artemchip/WattMeter/README.md

# Умный электросчетчик
Учет расхода энергии в сетях 220В с помощью трансформатора тока.  
Устройство:  
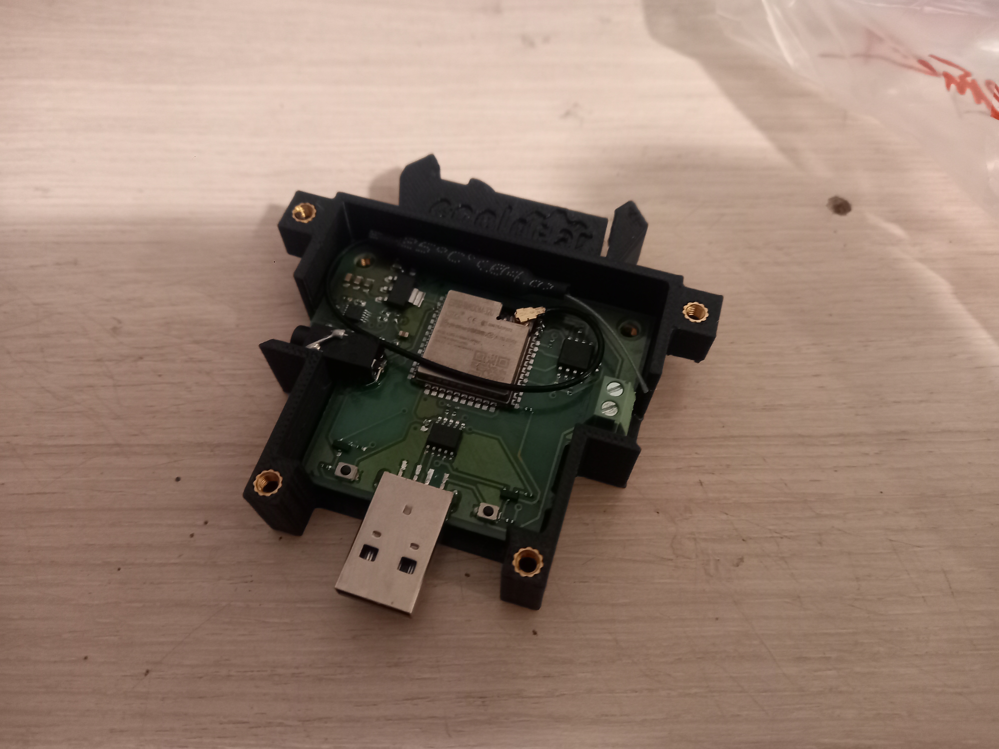
[picture p1: Photos/image1.jpg]

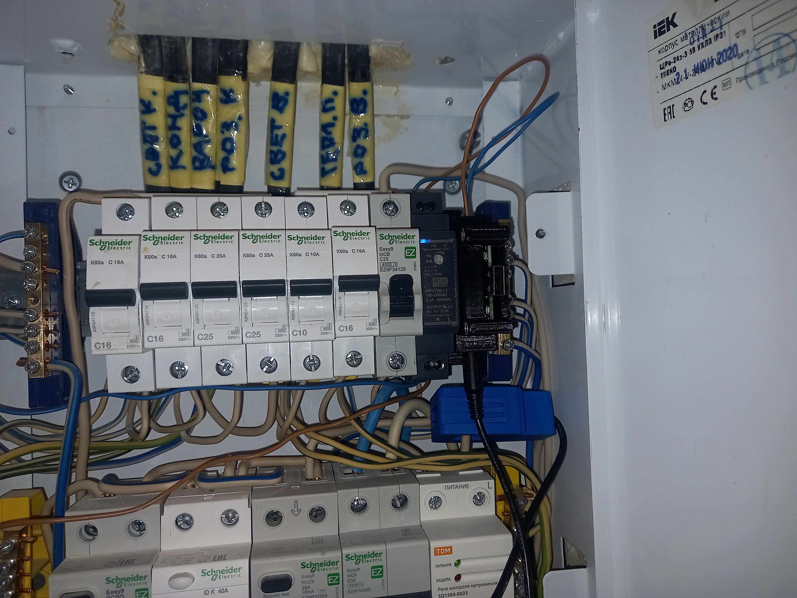
[picture p2: Photos/image2.jpg]

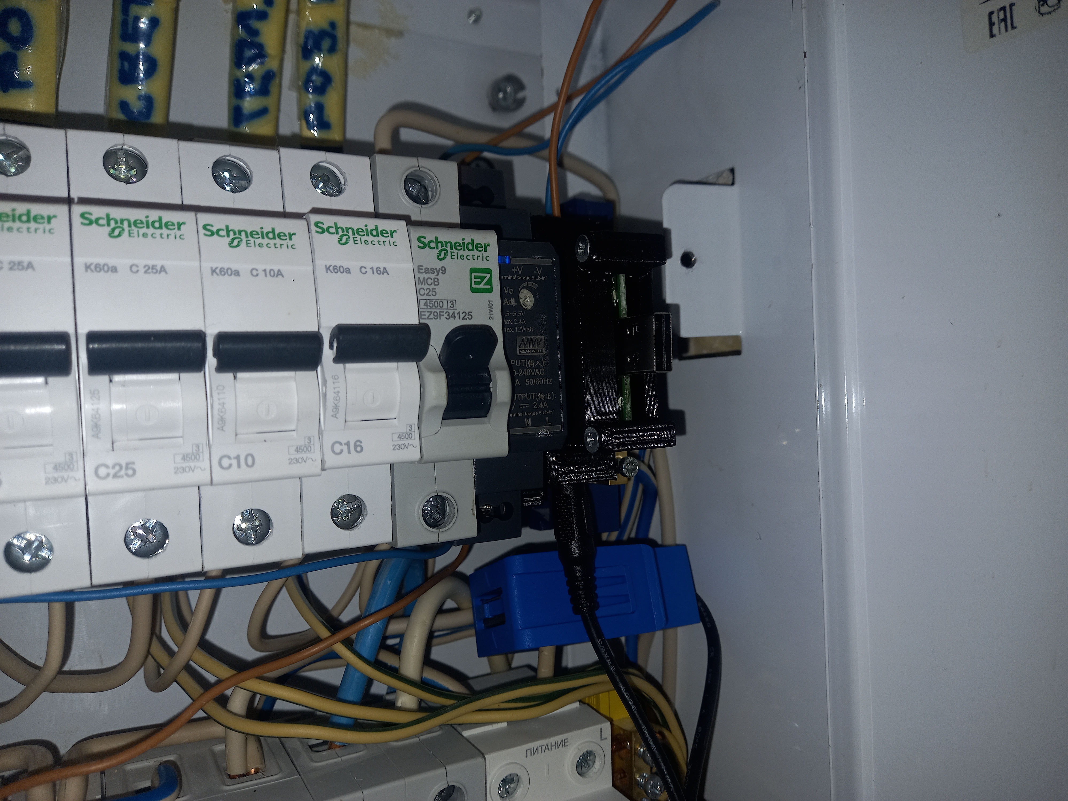
[picture p3: Photos/image3.jpg]

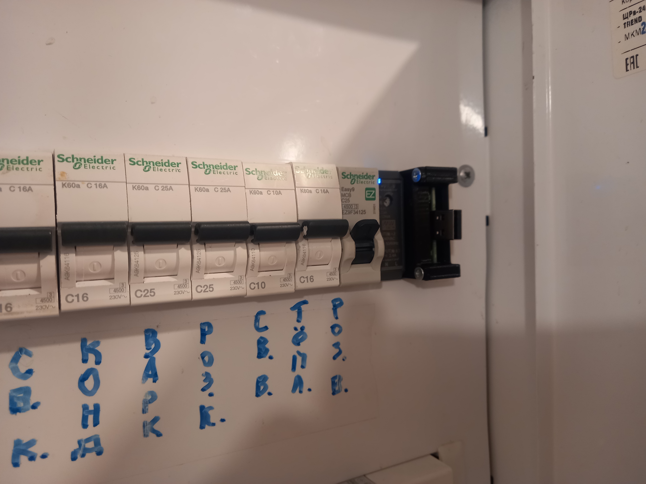
[picture p4: Photos/image4.jpg]


UI:  
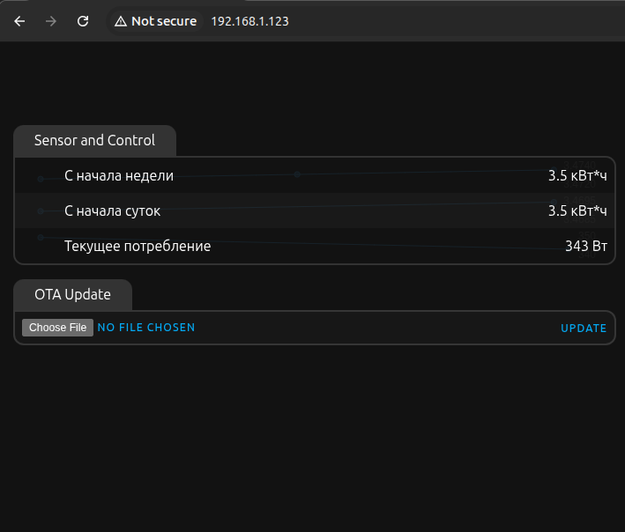
[picture p5: Photos/screenshot.png]


Скоро возможно будет функция постройки графиков.
