artemchip/WattMeter/(list of files, cad)

Other CAD files:
Hardware/wattmeter.blend
