artemchip/WattMeter/Hardware/WattMeter.brd

## EAGLE design Hardware/WattMeter.brd (2026-10-13)

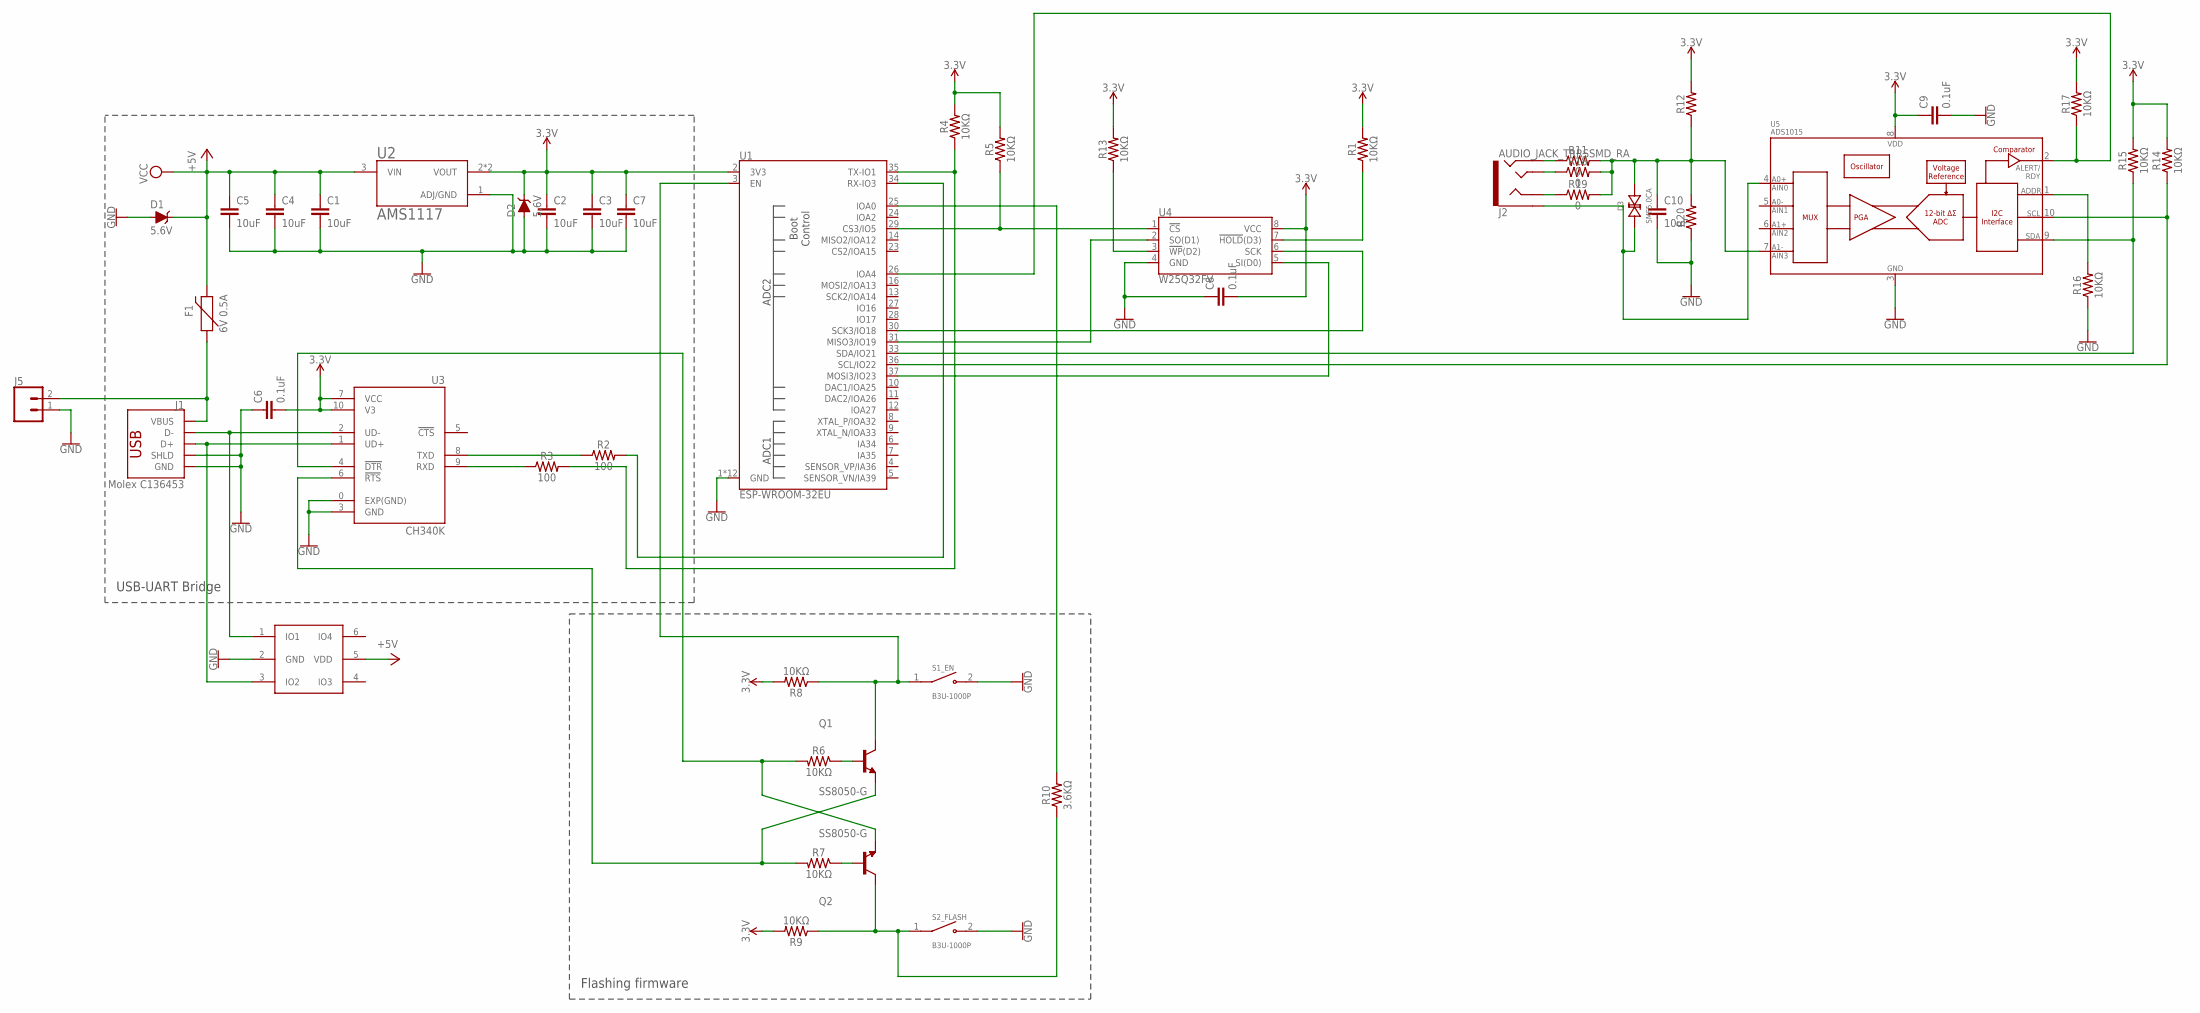
[picture p6: schematic WattMeter.sch]

Parts:
C1, C2, C3, C4, C5, C7, C10: 10uF; 0603
C6, C8, C9: 0.1uF; 0402
D1, D2: 5.6V; SOD-323
D3: SMF5.0CA; SOD-123FL
F1: 6V 0.5A; 0805
J1: Molex C136453; USB-A-SMT-MALE
J2: AUDIO_JACK_TRRSSMD_RA; AUDIO_JACK_3.5MM_TRRS_SMD_RA
J5: CONN_023.5MM; SCREWTERMINAL-3.5MM-2
Q1, Q2: SS8050-G; TRANS_SS8050-G
R1, R4, R5, R6, R7, R8, R9, R13, R14, R15, R16, R17: 10KΩ; 0402-TIGHT
R2, R3: 100; 0402-TIGHT
R10: 3.6KΩ; 0402-TIGHT
R11, R18, R19: 0; 0402
R12, R20: 10KΩ; 0402
S1_EN, S2_FLASH: B3U-1000P; SW_B3U-1000P
U1: ESP-WROOM-32EU
U2: AMS1117; SOT229P700X180-4N
U3: CH340K; SOP100P600X160-11N
U4: W25Q32FV; SOIC-8
U5: ADS1015; MSOP10
U6: AZC099-04S; SOT95P275X110-6N

Connections:
3.3V: C2.1, C3.1, C6.2, C7.1, C8.2, C9.1, D2.C, R1.2, R4.2, R5.2, R8.2, R9.2, R12.2, R13.2, R14.2, R15.2, R17.2, U1.2 (3V3), U2.2 (VOUT), U2.4 (VOUT), U3.7 (VCC), U3.10 (V3), U4.8 (VCC), U5.8 (VDD)
+5V: C1.1, C4.1, C5.1, D1.C, F1.2, U2.3 (VIN), U6.5 (VDD)
GND: C1.2, C2.2, C3.2, C4.2, C5.2, C6.1, C7.2, C8.1, C9.2, C10.2, D1.A, D2.A, J1.GND1 (GND), J1.SHLD1 (SHLD), J1.SHLD2 (SHLD), J5.1, R16.1, R20.1, S1_EN.2, S2_FLASH.2, U1.1 (GND), U1.15 (GND), U1.38 (GND), U1.GND, U1.GNDT1 (GND), U1.GNDT2 (GND), U1.GNDT3 (GND), U1.GNDT4 (GND), U1.GNDT5 (GND), U1.GNDT6 (GND), U1.GNDT7 (GND), U1.GNDT8 (GND), U2.1 (ADJ/GND), U3.0 (EXP(GND)), U3.3 (GND), U4.4 (GND), U5.3 (VSS), U6.2 (GND)
unnamed: J1.D-1 (D-), U3.2 (UD-), U6.1 (IO1)
unnamed: U1.31 (MISO3/IO19), U4.2 (SO(D1))
unnamed: J1.D+1 (D+), U3.1 (UD+), U6.3 (IO2)
unnamed: Q2.1 (B), R7.1
unnamed: R2.1, U3.8 (TXD)
unnamed: Q2.2 (E), R6.2, U3.4 (!DTR)
unnamed: Q1.2 (E), R7.2, U3.6 (!RTS)
unnamed: R3.1, U3.9 (RXD)
unnamed: U1.37 (MOSI3/IO23), U4.5 (SI(D0))
unnamed: U1.30 (SCK3/IO18), U4.6 (SCK)
unnamed: R1.1, U4.7 (!HOLD!(D3))
unnamed: Q2.3 (C), R9.1, R10.1, S2_FLASH.1
unnamed: Q1.1 (B), R6.1
unnamed: R3.2, R4.1, U1.35 (TX-IO1)
unnamed: R2.2, U1.34 (RX-IO3)
unnamed: R5.1, U1.29 (CS3/IO5), U4.1 (!CS!)
unnamed: R13.1, U4.3 (!WP!(D2))
unnamed: Q1.3 (C), R8.1, S1_EN.1, U1.3 (EN)
unnamed: R10.2, U1.25 (IOA0)
unnamed: R15.1, U1.33 (SDA/IO21), U5.9 (SDA)
unnamed: R14.1, U1.36 (SCL/IO22), U5.10 (SCL)
unnamed: D3.P$1 (1), J2.EARTH, U5.4 (AIN0)
unnamed: R16.2, U5.1 (ADDR)
unnamed: R17.1, U1.26 (IOA4), U5.2 (ALERT/RDY)
unnamed: C10.1, D3.P$2 (2), R11.2, R12.1, R18.2, R19.2, R20.2, U5.7 (AIN3)
unnamed: J2.RING2, R11.1
unnamed: F1.1, J1.VBUS1 (VBUS), J5.2
unnamed: J2.TIP, R18.1
unnamed: J2.RING1, R19.1

Notes on the sheet:
Flashing firmware
USB-UART Bridge

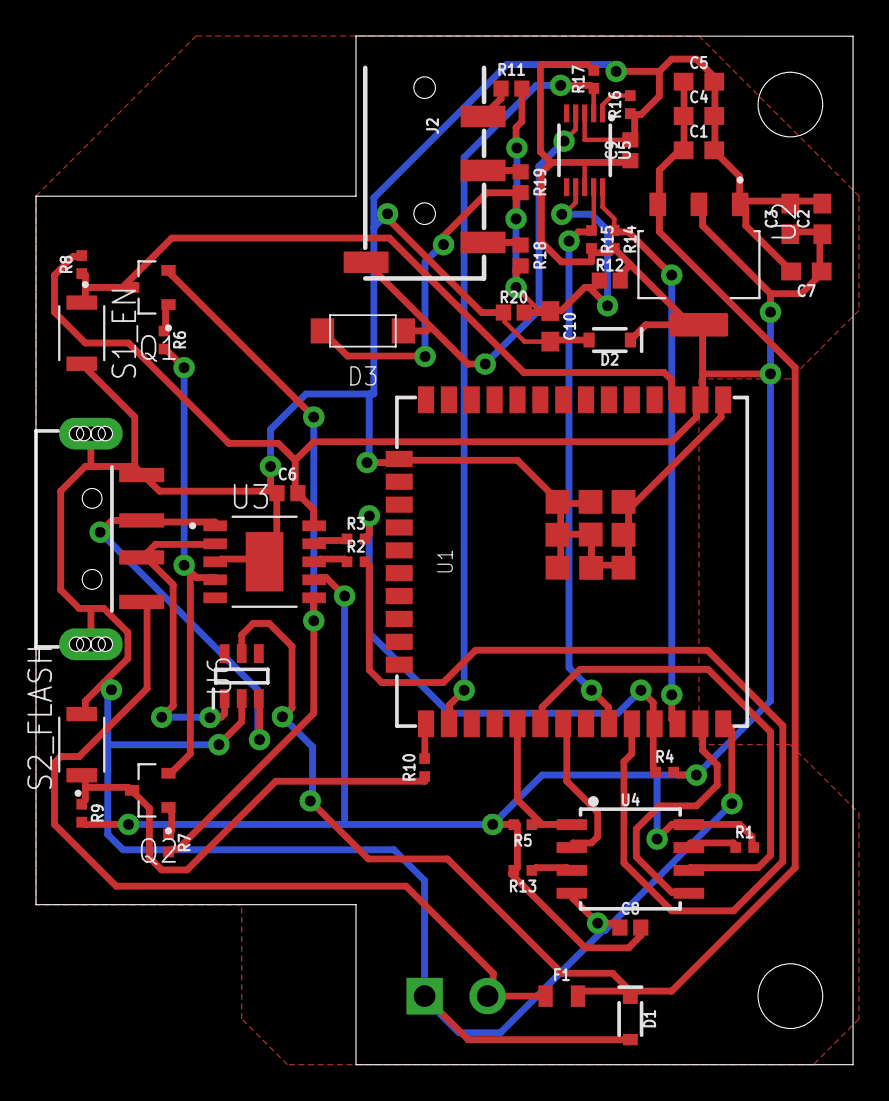
[picture p7: board WattMeter.brd from above]

Board: 2 copper layers, 45.4 x 57.1 mm, 47 parts (1 on the bottom side), 32 nets.
