artemchip/WattMeter/(commit log)

2026-09-20 Первый коммит
    [WattMeter.brd, WattMeter.sch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]
2026-10-13 Защита от скачков по USB
    [WattMeter.brd, WattMeter.sch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]
